ultimachine/Archim/ProjectOutputs/Photos/archim0.2a.jpg

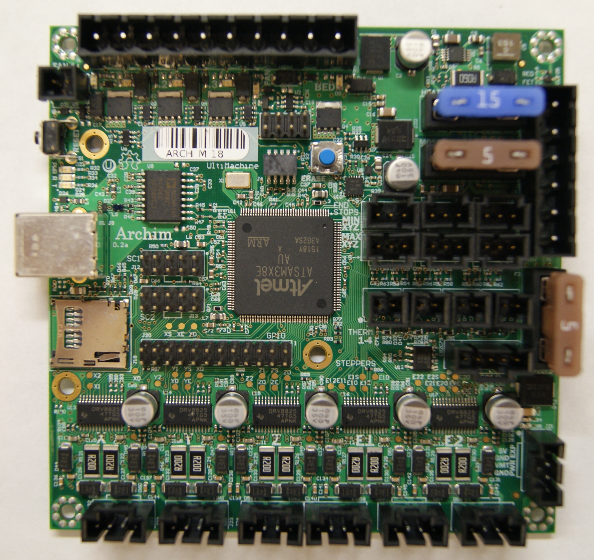
ProjectOutputs/Photos/archim0.2a.jpg
