ultimachine/Archim/ProjectOutputs/Photos/archim0.3b.jpg

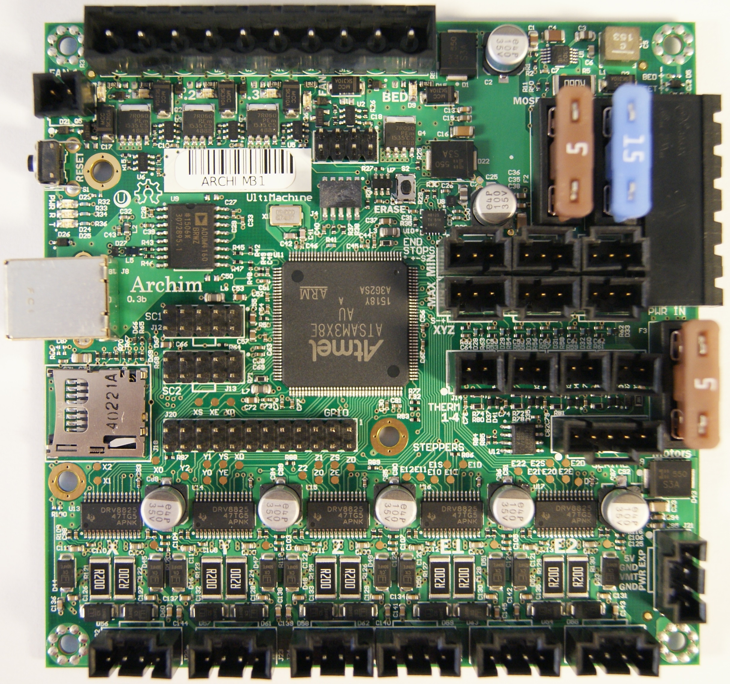
ProjectOutputs/Photos/archim0.3b.jpg
