ultimachine/Archim/Panels/ProjectOutputs/readme.txt

Readme File for Printed Circuit Board 'UMARCHIM03B'

Board Specification
Part Number            ARCHIM
Revision               03b
Board size             104.14 x 102.87mm
Board Thickness        1.524mm (0.06")
Board type             Rigid
Number of layers       4
P.C.B material         RoHS TG170
Finished Copper        2oz, 1oz (See Stackup)
Finish                 ENIG (Gold) (Lead free) (RoHS)
Mask type              LPI 
Mask color             GREEN
Silk screen color      WHITE
Silk screen Sides      BOTH 
Min trace width        
Min clearance          
Min Hole Diameter >=   
Gold Edge Connectors   No
Internal slots/routes  0
Blind Vias             No
Buried Vias            No
No of Boards/Panel     2
Routing                V-Score
Panel Size     117.17 X 218.69mm

Drill format           Leading zero suppression 2.4

Special Requirements
1. Fabricate PCB in accordiance with IPC-A-600 CLASS 2 (LATEST REVISION)
2. The PCB must be lead free assembly process compatible.
  Must handle minimum 6 cycles - 260C for 10 seconds.
3. Please ship panels including rails with tooling holes and fiducials in gerber files.
4.UL LOGO + ID and ROHS logo to be placed on solder side (bottom silk screen) by board fab in regions .

Critical Tolerances: None

Layer Description
(Note: Inner layers are counted from the top downwards)
Top Paste                     Archim_Panel_0.3b.GTP
Top Silk Screen               Archim_Panel_0.3b.GTO
Top Solder Mask               Archim_Panel_0.3b.GTS
Top Copper                    Archim_Panel_0.3b.GTL
Inner Layer 1                 Archim_Panel_0.3b.GP1
Inner Layer 2                 Archim_Panel_0.3b.GP2
Bottom Copper                 Archim_Panel_0.3b.GBL
Bottom Solder Mask            Archim_Panel_0.3b.GBS
Bottom Silk Screen            Archim_Panel_0.3b.GBO
NC Drill File                 Archim_Panel_0.3b.TXT
Board Outline	     		        Archim_Panel_0.3b.GM1
Fabrication Notes             Archim_Panel_0.3b.GM2
V-Score                       Archim_Panel_0.3b.GM31
Panel Outline                 Archim_Panel_0.3b.GM32

Contact Information
Address
Company        UltiMachine
Address        200 12th St. N.
City           South Pittsburg
State          TN
PostCode       37380
Country        USA
Email          info@ultimachine.com
Phone          423-228-0005

Purchasing contact : Lee Turner - lee@ultimachine.com
Technical contact  : Johnny Russell - johnny@ultimachine.com

Please quote quantities / lead time:
32 pcs = 16 panels / 2 weeks
106 pcs = 53 panels
510 pcs = 255 panels
1020 pcs = 510 panels
