ultimachine/Archim/ProjectOutputs/Report Board Stack/Archim_0.3a.xls

Board Stack Report
Stack Up |  | Layer Stack
Layer | Board Layer Stack | Name | Material | Thickness | Constant
1 |  | Top Paste
2 |  | Top Overlay
3 |  | Top Solder | Solder Resist | 0.40mil | 3.5
4 |  | Top Layer | Copper | 2.80mil
5 |  | Dielectric1 | FR-4 TG170 | 5.40mil | 4.6
6 |  | Ground Plane | Copper | 1.40mil
7 |  | Dielectric2 | FR-4 TG170 | 40.00mil | 4.6
8 |  | Power Plane | Copper | 1.40mil
9 |  | Dielectric3 | FR-4 TG170 | 5.40mil | 4.6
10 |  | Bottom Layer | Copper | 2.80mil
11 |  | Bottom Solder | Solder Resist | 0.40mil | 3.5
12 |  | Bottom Overlay
13 |  | Bottom Paste
 | Height : 60.00mil
