ultimachine/Archim/(list of files, drawings)

Other design files:
Archim.PrjPcb
EndStops.SchDoc
Microcontroller.SchDoc
Mosfets.SchDoc
Motor-Z.SchDoc
Motors.SchDoc
Panels/Archim-panel.PcbDoc
Panels/Archim-panel.PrjPcb
Power.SchDoc
PWMfilterSims.SchDoc
Thermistors.SchDoc
ThermistorSim.SchDoc
USB.SchDoc
