ultimachine/Archim/(threads)

Thread 2 (2019-02-15):

Archim 1.0.a HW

apan018, 2019-02-15:
problem flashing...

it will flash half way (COM port change from 3D Printer Powered by RAMbo -> Bossa Program Port ) and as soon as it switch again back to 3D printer by RAMbo this is when it failed

log:

[==============================] 100% (559/559 pages)
Verify successful
done in 4.471 seconds
Set boot flash true
readWord(addr=0x400e0a08)=0x1
readWord(addr=0x400e0c08)=0x1
writeWord(addr=0x400e0a04,value=0x5a00010b)
readWord(addr=0x400e0a08)=0
readWord(addr=0x400e0c08)=0x1
readWord(addr=0x400e0a08)=0x1
readWord(addr=0x400e0c08)=0x1
CPU reset.
readWord(addr=0)=0x20088000
readWord(addr=0xe000ed00)=0x412fc230
readWord(addr=0x400e0740)=0
readWord(addr=0x400e0940)=0x285e0a60
writeWord(addr=0x400e1a00,value=0xa500000d)
Couldn't find a Board on the selected port. Check that you have the correct port selected.  If it is correct, try pressing the board's reset button after initiating the upload.

Thread 3 (2022-08-23):

CONTROLLER_FAN_PIN assignment?

orrinwitt, 2022-08-23:
Hoping someone will see this...

I'm having a little trouble navigating the schematics to know which pins I should be using and then assigning (if necessary) to the CONTROLLER_FAN_PIN.
I need a fan to be cooling the stepper drivers (they have heat sinks too), and I'd love it if it came on automatically like it should.

Any help will be greatly appreciated!

orrinwitt, 2022-08-29:
For anyone that finds this: I just ended up editing the PINS file to use one of the extra HEATER pins. All I had to do was to rename it there, and everything worked perfectly.

Closed 2022-08-29.
