ultimachine/Archim/(commit log)

2015-08-19 move panel files to subfolder
    [AMBIT-panel.PcbDoc, AMBIT-panel.PrjPcb]
2015-08-20 push prototype BOM
    [AMBIT_0.1b.xls]
2015-08-28 Cleanup for protos
    update outjob
    10uF input decouple TBD
    rename ATSAM part
    fix typo on 10r part value
    consolidate libraries for components with multiple bom lines 100nF, 10nF 0402
2015-08-28 Cleanup for protos2 (previous commmit incomplete)
    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
    [AMBIT.PrjPcb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]
2015-08-28 Change z motor bulk cap PN to match others
    [AMBIT.PrjPcb, Motor-Z.SchDoc]
2015-09-06 Output job source updated Now generated from any PCB in the project. This makes the output job useful for other projects.
2015-09-06 Fix SMAJ30A orientation
    [Motor-Z.SchDoc, Motors.SchDoc]
2015-09-06 Improve 1N4148 symbol
    [Thermistors.SchDoc]
2015-09-06 Add FB resistors to SMPS(incorrectly NP)
    [Power.SchDoc]
2015-09-06 VUSB Must be conn to 3.3V. Replace R42 w/ direct connection to 3.3V.
    [USB.SchDoc]
2015-09-06 Pull SMPS bottom polygon back from board edge
2015-09-08 Add buffer for 3.3V>5V for fets
    [AMBIT.PrjPcb, Mosfets.SchDoc]
2015-09-08 ECOs for Fet buffer-previous commit
2015-09-09 FET driver level shifter Silk and schematic + add endstop pinout to top silk add power input labels to bottom silk
    [Mosfets.SchDoc]
2015-09-10 tweak 3.3V reg pad paste
2015-09-10 Schematic fixes PA14, PA15 names mixed move tied pins to connector so it is clearer what is going on
    [Microcontroller.SchDoc]
2015-09-10 SD closer to edge of PCB
2015-09-10 Add reset to serial connector minor mcu schematic organizing
    [Microcontroller.SchDoc]
2015-09-11 fix spi flash signals reversed
2015-09-11 fix spi flash signals reversed-schem
    [Microcontroller.SchDoc]
2015-09-11 heat LEDs=red, update calcs
    [Mosfets.SchDoc, calcs.ods]
2015-09-11 fan driver pull down = 1K
    [Mosfets.SchDoc]
2015-09-11 SMPS feedback resistors = 0402 reduce part count by using part already in BOM
    [Power.SchDoc]
2015-09-11 Add pull up to motor enables, re-annotate 10K pull up will prevent motors enabling when input not driven had to reannotate project due to motors being in channels
    [AMBIT.PrjPcb, EndStops.SchDoc, Microcontroller.SchDoc, Mosfets.SchDoc, Motor-Z.SchDoc, Motors.SchDoc, Power.SchDoc, Thermistors.SchDoc]
2015-09-11 fix dup designator and classes
    [Motors.SchDoc]
2015-09-15 squeeze fets to make room for serial label
    [calcs.ods]
2015-09-15 Remove 3.3V from power extension header
    [Power.SchDoc]
2015-09-15 Silk fixes Overlaps from adding enable pull up resistors tweak heat label incorrect power output bottom overlay from changing the pinout
2015-09-18 Add ESD to SD, rotate motor input diode silk fixes
    [Microcontroller.SchDoc]
2015-09-19 Push TVS part away from USB conn. Remove extra decoupling cap by USB conn
    [USB.SchDoc]
2015-09-21 fix annular ring on NRST on power plane
2015-09-21 fix paste shrink for 3.3V reg
2015-09-21 reorganize outputs,generate gerbers for 0.2a
    [AMBIT-panel.PrjPcb, AMBIT.PrjPcb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]
2015-09-21 Rename pdf outputs
    [calcs.ods]
2015-09-22 add step output, render special strings in pcb
    [AMBIT.PrjPcb]
2015-10-20 Add pads to bypass fet drivers (again)
2015-11-13 FET connector rotate and re-pin to march rambo, etc. add power connector for extension modules update silk screen. Name change to Archim
2015-11-13 FET connector rotate--continued
    [AMBIT-panel.PcbDoc, AMBIT-panel.PrjPcb, AMBIT.PrjPcb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]
2015-11-16 Change file name. Fix panel dims. Gen Gerbers
    [AMBIT-panel.PcbDoc, AMBIT-panel.PrjPcb, AMBIT.PrjPcb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]
2016-06-01 0.2 gerbers
    [Archim_0.2a.csv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]
2016-06-01 change sot889 paste - untested
    [Archim.PrjPcb]
2016-06-02 photo of board
2016-08-25 rotate fuses and pwr input. connect usb shield directly
    [Power.SchDoc, calcs.ods]
2016-08-25 increment version 0.3a. silk fixes. extra via in 5V
    [Archim.PrjPcb, Microcontroller.SchDoc, Power.SchDoc, USB.SchDoc]
2016-09-01 0.3a gerber generation
    [Archim-panel.PrjPcb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]
2016-09-02 control stepper decay w/ dio. v0.3b
    [Archim-panel.PrjPcb, Archim.PrjPcb, Archim_0.3a.xls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]
2016-09-14 control stepper decay w/ DIO. v0.3b. gerber gen
    [Archim-panel.PrjPcb, Archim.PrjPcb, Archim_0.3a.xls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]
